SiLiCaP/chipathon-2026/specs/Spec 3 Control Loop and Integration.md

# Spec 3: Control Loop and Integration

Oct 17, 2026 · @A

## Your job

You own control, sequencing and the final wiring. The other four people hand you finished blocks, and you build `ntt_core` around them so all four modes run correctly.

- **In scope:** the op latch and job state machine, all counters, the ROM and γ select, the operand registers, the multiplexers, the bypass delay line, the loop-back path, cancel and reset, and wiring every block together.
- **Out of scope:** the inside of the multiplier, adders, packer and input capture, and the host side.
- **You hold the interface table.** Anyone who wants to change a port asks you first, and you update all five specs.

You are the one person who sees every block, so three things are yours to publish early: the interface table, the per-mode schedule and the output delay table. The section "What you publish to the other four, and when" lists them.

## Who owns which block

You build `ntt_core` and everything inside it except the arithmetic blocks, which you instantiate. The block diagram is on the architecture page listed in the shared rules.

| Block | Module | Owner |
| --- | --- | --- |
| Multiplier | `modq_mul` | Multiplier |
| Add/subtract, one for Pre ± and one for Post ± | `modq_addsub` | Adders |
| Running sums for basemul, two of them | `modq_acc` | Adders |
| Pin capture | `io_in_capture` | I/O |
| Output packer | `io_out_pack` | I/O |
| Tiny Tapeout shell | `tt_um_*` | I/O |
| Host harness, reference model, vectors | not RTL | Pi |
| Everything else in `ntt_core` | `ntt_core` | You |

Inside `ntt_core` you build: the op latch and job FSM, the counters, `zeta_rom` with the ζ / γ select and the scale constant 304, the operand registers (b and a, or g1 f1 g0 f0), the B-input select, the Pre and Post pass-through muxes, the bypass delay line, the loop-back path, the result pairing for scale, and the flush.

`ntt_core` is the boundary with the I/O owner. Its ports are fixed as follows.

| Port | Dir | Width | Meaning |
| --- | --- | --- | --- |
| `clk`, `rst_n` | in | 1 each | Clock and synchronous reset |
| `coeff_q` | in | 12 | Captured coefficient, from `io_in_capture` |
| `valid_q` | in | 1 | Captured valid. The shell masks hash words (coefficient bits 11:8 = 0xF, Spec 5) out of it and out of `sof_q` |
| `sof_q` | in | 1 | High only when valid and sof were both high |
| `op_q` | in | 2 | Captured op. Read only when `sof_q` is high |
| `r0` | out | 12 | First result of a pair |
| `r1` | out | 12 | Second result of a pair |
| `pair_valid` | out | 1 | High for one clock when `r0` and `r1` are valid |
| `flush` | out | 1 | High for one clock when a job is cancelled. Goes to `io_out_pack` |

## Op latch, modes and job lifecycle

A job starts on the clock where `valid_q` and `sof_q` are both high. You latch `op_q` on that clock and run that mode until its last result.

- **Idle.** Wait for `valid_q` and `sof_q`. Coefficients that arrive with `valid_q` but no earlier sof are ignored.
- **Start.** On the sof clock, latch the op, clear every counter, and take this coefficient as the first input of the job.
- **Running.** Take a coefficient on every clock where `valid_q` is high, in the order the mode defines. Clocks with `valid_q` low are skipped and change no counter.
- **End.** After the last pair is emitted the job ends by itself and you return to idle. Extra coefficients after the last expected one are ignored until the next sof.
- **Cancel.** A new sof while running cancels the job. See the cancel section.

You know each job's length from the mode. The host never sends it.

| op | Mode | Inputs | Result pairs out |
| --- | --- | --- | --- |
| 00 | Forward NTT | 1792 | 896 |
| 01 | Inverse NTT | 1792 | 896 |
| 10 | Basemul | 512 | 128 |
| 11 | Scale | 256 | 128 |

## Counters, ROM index and constants

You pick every constant. The host only sends coefficients.

**ROM.** `zeta_rom.v` holds the scaled table ROM′\[k\] = 17^BitRev7(k) × 2197⁻¹ mod 3329 for k = 0..127, where 2197⁻¹ = 944. The multiplier returns 2197 × a × b (three K-RED rounds, see the Multiplier spec), so with a stored ζ′ the product b × ζ′ comes out as b × ζ. It was generated by script and has never been compiled. Compile it, lint it, and compare all 128 entries with the Pi owner's scaled table.

**Forward NTT.** The ROM index starts at 1 and goes up by 1 after every block. A block is `len` butterflies that share one ζ. There are 127 blocks and 896 butterflies.

| len | Blocks | Butterflies per block | ROM indices |
| --- | --- | --- | --- |
| 128 | 1 | 128 | 1 |
| 64 | 2 | 64 | 2 to 3 |
| 32 | 4 | 32 | 4 to 7 |
| 16 | 8 | 16 | 8 to 15 |
| 8 | 16 | 8 | 16 to 31 |
| 4 | 32 | 4 | 32 to 63 |
| 2 | 64 | 2 | 64 to 127 |

**Inverse NTT.** The same table read from the bottom up. `len` goes 2, 4, ..., 128, and the ROM index starts at 127 and goes down by 1 after every block, ending at 1. For len = 2 it covers 127 down to 64, and for len = 128 it is 1.

**Basemul.** A piece counter runs 0..127. With j = i >> 1, the scaled γ′ for piece i is ROM′\[64 + j\] when i is even and 3329 minus that entry when i is odd. One subtractor makes the negative, and no ROM′ entry is 0. The loop-back multiplies m1 by γ′, so m2 = 2197 × m1 × γ′ = m1 × γ.

**Scale.** The constant is 304 = 3303 × 2197⁻² mod 3329 (128 × 3303 = 127 × 3329 + 1), fixed in wiring. The ROM is idle. In the full flow its input already carries one factor of 2197 from basemul, so the multiplier's own 2197 leaves a net factor of 3303.

Checks from the reference model (scaled table): ROM′\[0\] = 944, ROM′\[1\] = 966, ROM′\[2\] = 2021, ROM′\[3\] = 2188, ROM′\[64\] = 2732 and ROM′\[127\] = 2686. γ′ for pieces 0, 1, 2, 3 is 2732, 597, 3106, 223, and for pieces 126, 127 it is 2686, 643. For reference, the unscaled table has ROM\[1\] = 1729, ROM\[64\] = 17, ROM\[127\] = 2154.

## What the pins show because of K-RED

The multiplier returns 2197 × the product. Your scaled constants cancel the factor in both NTT modes, so those are plain. Basemul keeps it, and scale removes it.

| Mode | What the output bytes carry |
| --- | --- |
| Forward NTT | The plain FIPS 203 result |
| Inverse NTT | The plain FIPS 203 result for plain input. For basemul output as input it gives 2197 × the plain result (the transform is linear) |
| Basemul | 2197 × the plain basemul, mod 3329 |
| Scale | c × 3303 × 2197⁻¹ mod 3329 |

So the host flow forward, forward, basemul, inverse, scale gives the correct final polynomial. Scale on its own is not a plain × 3303.

Worked values for your tests:

- Basemul with f0 = 5, f1 = 7, g0 = 11, g1 = 13 and γ = 17 (plain answer c0 = 1602, c1 = 142): the products are m1 = 187, m2 = 3179, m3 = 991, m4 = 2987, m5 = 2719, so the pins give c0 = 841 and c1 = 2377.
- Scale input 2197 gives 3303. Scale input 3259 gives 316. Scale input 1132 gives 26 (inputs that carry 2197, as basemul output does, come out as plain × 3303).
- Forward butterfly with b = 2000, a = 1000, ζ = 1729: t = 2498, a′ = 169, b′ = 1831.

Tell the Pi owner if you change any of this, because the reference model, the vector files and the demo depend on it.

## Per-mode schedules

Every mode repeats on a fixed period: 3 clocks per butterfly in forward and inverse, 5 clocks per basemul piece, and 3 clocks per scale pair. Each mode runs as fast as its real limit allows:

| Mode | Clocks per unit | Limited by |
| --- | --- | --- |
| Forward and inverse NTT | 3 per butterfly | Output pins: 3 bytes per butterfly |
| Basemul | 5 per piece | Multiplier: 5 products per piece, one start per clock |
| Scale | 3 per pair | Output pins: 3 bytes per pair |

The multiplier starts on consecutive clocks in basemul and scale (full rate, Oct 17 change). In the NTT modes it starts once every 3 clocks because the pins can't carry results any faster.

The tables below are the required cadence. Publish them as `schedule.md`. Offsets are clocks from the unit's first input, and idle clocks have `valid` low.

**Forward NTT, one butterfly (period 3)**

| Offset | Host sends | Chip does |
| --- | --- | --- |
| 0 | b | Capture b |
| 1 | a | Start b × ζ right away, because only b is multiplied. Hold a |
| 2 | idle | Multiplier digit clocks |
| t arrives | none | Post ±: a + t and a − t. Pair out: r0 = a', r1 = b' |

**Inverse NTT, one butterfly (period 3)**

| Offset | Host sends | Chip does |
| --- | --- | --- |
| 0 | b | Capture b |
| 1 | a | Capture a |
| 2 | idle | Pre ±: a + b and b − a, into the Pre ± output register (`REG_OUT` = 1) |
| 3 | next b | Start (b − a) × ζ. Delay a + b. `zeta_r` still holds this unit's ζ′ on this clock |
| product arrives | none | Pair out: r0 = a + b (delayed), r1 = (b − a) × ζ |

The inverse needs both inputs before the multiplier can start, and the Pre ± result is registered (see Timing closure), which is why its output delay is larger than forward's.

**Basemul, one piece (period 5)**

The host sends g1, f1, g0, f0 on 4 consecutive clocks, then one idle clock, and the next piece starts at 5. Core offsets count from the clock g1 is on `coeff_q`. With L\_mult = 3:

| Core offset | Host sends | Chip does |
| --- | --- | --- |
| 0 | g1 | g1 → R0. Look up γ′ → `zeta_r` |
| 1 | f1 | f1 → R1 |
| 2 | g0 | g0 → R2. Start m1 = f1 × g1 |
| 3 | f0 | f0 → R3. Start m5 = f1 × g0 |
| 4 | idle | Start m4 = f0 × g1 (last use of g1) |
| 5 | next g1 | Start m2 = m1 × γ′, with m1 taken straight from `p_out` as it arrives. The next piece's g1 → R0 and its γ′ lookup happen on this clock; `zeta_r` still holds this piece's γ′ |
| 6 | next f1 | Start m3 = f0 × g0. m5 back: acc1 ← m5 |
| 7 | | m4 back: acc1 ← acc1 + m4 = c1 |
| 8 | | m2 back: acc0 ← m2 |
| 9 | | m3 back: acc0 ← acc0 + m3 = c0 |
| 10 | | Pair out: r0 = c0, r1 = c1 |

- f1 and g1 come first because f1 × g1 × γ is the only chain of two multiplications. m2 starts exactly L\_mult clocks after m1.
- The multiplier starts on 5 consecutive clocks (2 to 6). The next piece's starts are 7 to 11, so they never collide.
- Every operand register is read for the last time before the next piece overwrites it: g1 at 4 (next write at 5), f1 at 3 (6), g0 at 6 (7), f0 at 6 (8).
- c1 loads m5 and adds m4; c0 loads m2 and adds m3. Both accumulators hold until the pair goes out at 10, before the next piece loads them at 11 and 13.

**Scale, one pair (period 3)**

The host sends c and c′ on consecutive clocks, then one idle clock. Each result is c × 304 (net c × 3303 in the full flow, see the K-RED section).

| Core offset | Host sends | Chip does |
| --- | --- | --- |
| 0 | c | c → R0 |
| 1 | c′ | Start c × 304. c′ → R1 |
| 2 | idle | Start c′ × 304 |
| 4 | | First product back: hold as r0 |
| 5 | | Pair out: r0 = held, r1 = second product |

Streaming job lengths with this cadence: forward and inverse 896 butterflies × 3 = 2688 clocks, basemul 128 × 5 = 640, scale 128 pairs × 3 = 384. These exclude the host's waits between NTT layers.

## Latency and alignment

Results must reach the Post ± stage together, so you delay the shorter lane to match the longer one.

- **Forward.** t = b × ζ arrives L\_mult clocks after the multiplier starts. The bypass value a waits in a delay line of the same length before Post ±.
- **Inverse.** The bypass lane carries a + b. The product (b − a) × ζ arrives L\_mult clocks after the start. Delay a + b to match.
- **Basemul.** m2 needs m1, so the 5-clock schedule above is built for L\_mult = 3 exactly. A multiplier with another latency needs a new schedule (and new host constants), so Spec 2 fixes the latency at 3.
- **Output delay D.** The first byte of a pair leaves D clocks after the pair's first input. The handoff assumed D = 5 forward and 7 inverse. The real value is the sum of the stage latencies below plus your own register stages.

| Stage | Owner | Reports |
| --- | --- | --- |
| Input capture | I/O | 1 clock |
| Multiplier | Multiplier | L\_mult = 3 (pipelined, one result per clock) |
| Add/subtract | Adders | 0 or 1 clock per instance |
| Output packer | I/O | 1 clock |
| Your registers, muxes and delay lines | You | Your own count |

Compute D for each mode and send the numbers to the Pi owner as `host_timing.md`. If D for forward comes out above 5, that is fine. Only a constants file on the host changes. With L\_mult = 3 and the cadence above, D = 6 forward, 8 inverse, 12 basemul and 7 scale (basemul: 1 capture + 10 + 1 packer; scale: 1 + 5 + 1). Forward is one clock over the handoff because the multiplier takes b from a register, one clock after it arrives. Inverse is one clock over the earlier 7 because the Pre ± result is registered.

Also check that `pair_valid` is never closer than 3 clocks apart, and add that as an assertion.

## Timing closure (Oct 17 change)

**Target:** 50 MHz (20 ns) at the slow corner (ss, 100 °C, 1.60 V) after place and route, with no setup or hold violation. Check it in the gds run's post-PnR STA: `local-ci/run gds` shows it on the results page, or read `runs/wokwi/*-openroad-stapostpnr/max_ss_100C_1v60/max.rpt`.

Why: before this change the chip missed the target by 3.6 ns, so it could compute wrong products on a hot or slow die. The worst path ran from the op latch through the `kind` decode and the multiplier's operand mux into the 12 × 12 multiply. The select logic alone took 14.5 ns, mostly fanout buffers driving the select across 24 mux bits; the multiply took about 9.5 ns.

Rules for the multiplier's inputs:

1. **Operand selects come straight from flip-flops.** Decode them one clock early, from the next clock's op and schedule position, into one-hot registers (one bit per source). The operand mux is then one AND-OR level.
2. **Pre ± uses `REG_OUT` = 1.** No adder sits in front of the multiplier. Inverse starts its product at offset 3, as in the table above.
3. **m2's loop-back operand comes from `p_out` directly.** The basemul schedule fixes that m1 is on `p_out` on the m2 start clock, so no comparison on the result tag sits in front of the multiplier.
4. **The ζ/γ lookup is short.** The ROM index logic runs from mode flags decoded into their own registers one clock early, not from the heavily loaded op latch. The γ negation for odd pieces (3329 − x) happens in a separate register one clock after the lookup, off the lookup path; m2 reads that register.

Measured on the full chip (LibreLane, post-PnR, slow corner, worst setup slack at 50 MHz):

| Change | Worst slack | Cell area |
| --- | --- | --- |
| Before (combinational `kind` decode, `PRE_LAT` = 0) | −3.59 ns | 36.4k µm² |
| Split the 12 × 12 multiply into two 12 × 6 halves (rejected) | −3.33 ns | 37.2k µm² |
| Rule 2 only | −2.14 ns | 37.7k µm² |
| Rule 1 only | −0.62 ns | 36.5k µm² |
| Rules 1 and 2 | +0.12 ns | 37.5k µm² |
| Rules 1 to 3 with the full-rate schedule | −0.47 ns (the ζ/γ lookup is now worst) | 37.6k µm² |
| **Rules 1 to 4 with the full-rate schedule (as built)** | **+1.41 ns, 0 violations** | 38.1k µm² |

With all four rules the worst path is the registered operand select through the 12 × 12 multiply. The multiplier block itself doesn't change. Re-check the slack in the gds run after any change to Control.

## Reset, cancel and flush

- **Reset.** `rst_n` low clears the counters, the operand register, the delay lines and the op latch. The chip is then idle and ready for a start of frame.
- **Start of frame.** A pin word with `sof` and `valid` both high starts a job. Latch `op` on that clock only, reset the counters, and drop any job still in progress.
- **Cancel.** A new start of frame always wins. Send `flush` to the output packer in the same clock so stale bytes are dropped.
- **Idle.** With `valid` low and no job running, every output is 0x00 and nothing toggles needlessly.
- **Unused op.** All four op codes are used, so there is no illegal code. Check the table anyway.

## Tests

- **Whole-core, per mode.** Run `ntt_core` with the other four blocks against the Pi owner's reference model: one forward layer, one inverse layer, basemul of two random polynomials, and scale.
- **Full flow.** Forward NTT of f and g, basemul, inverse NTT, scale. The result must equal schoolbook negacyclic multiplication mod 3329.
- **Output delay.** Measure D for each mode from the waveform. It must match `host_timing.md`.
- **Rates.** Check clocks per butterfly (3), per basemul piece (5) and per scale pair (3).
- **Reset and cancel.** Reset mid-job. Start a new frame mid-job. Both must leave no stale bytes.

## Deliverables and done when

**Hand over:**

- `ntt_core.v` with the ROM, counters, muxes, delay lines and control
- The interface table (every port, width and latency of the four blocks you connect)
- `schedule.md` (input offsets per mode) and `host_timing.md` (D and rates per mode)
- A whole-core testbench

**Done when:**

- All four modes match the reference model.
- The full polynomial multiply flow matches schoolbook.
- The assembled design passes the Tiny Tapeout flow.
- Post-PnR STA meets 50 MHz at the slow corner (see Timing closure).

**Do not:** change another owner's ports without agreeing it with them first.

## Risks to watch

- **Multiplier latency changes.** The basemul schedule depends on L\_mult = 3 (m2 starts on the clock m1 arrives). Any change to the multiplier's latency means a new schedule and new host constants.
- **Output delay differs from the handoff.** D of 5 and 7 are assumptions. Send the real numbers to the Pi owner early.
- **Area.** The ROM is 128 × 12 bits. If it does not fit, use the γ symmetry to store only 64 entries for basemul and derive the rest.
- **Layer-by-layer round trips.** The host re-sends data for every NTT layer because the chip stores nothing. Check the host counts against the timing table.

## Shared rules for all five specs

- **One chip, one clock.** Everything runs on `clk`. Reset is `rst_n`, active low. Synchronous logic only, no latches, no generated clocks.
- **Numbers.** Every coefficient is 12 bits, unsigned, always in 0..3328 on every port.
- **Ports are frozen.** You hold the interface table. Other owners tell you before changing a port, and you tell them.
- **Latency is reported.** Collect every block's latency from its README and publish `host_timing.md`.
- **Reference.** The Pi owner's Python model is the source of truth.
- **Sharing.** These docs are private. Share them with your teammates.
