SiLiCaP/chipathon-2026/schematics/adder.png

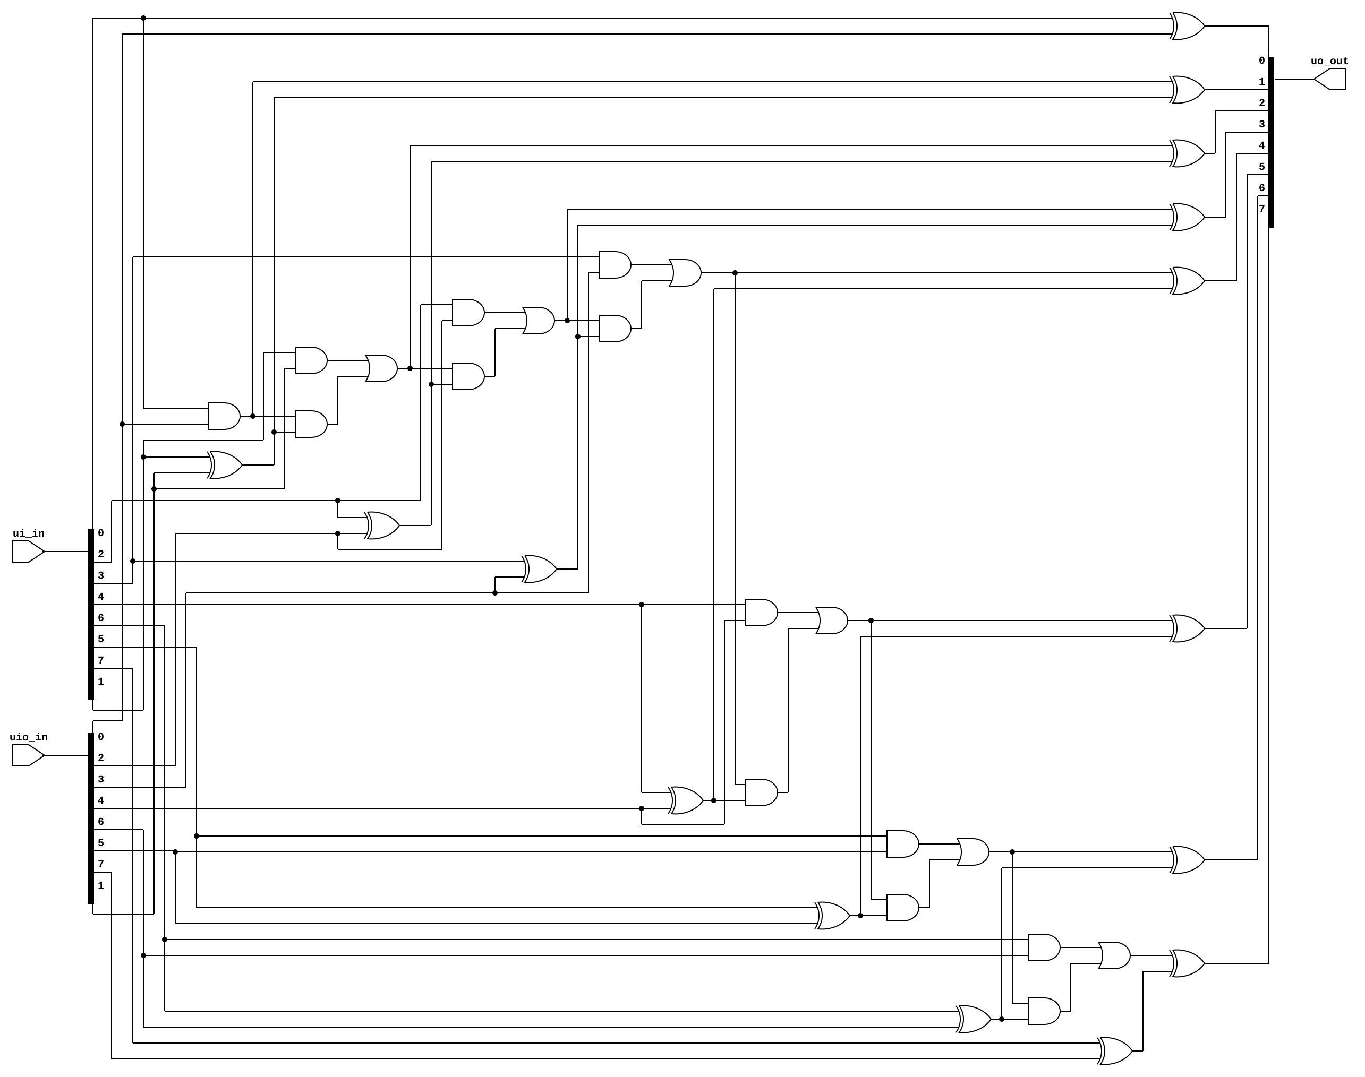
schematics/adder.png
