SiLiCaP/chipathon-2026/schematics/byte_serializer.png

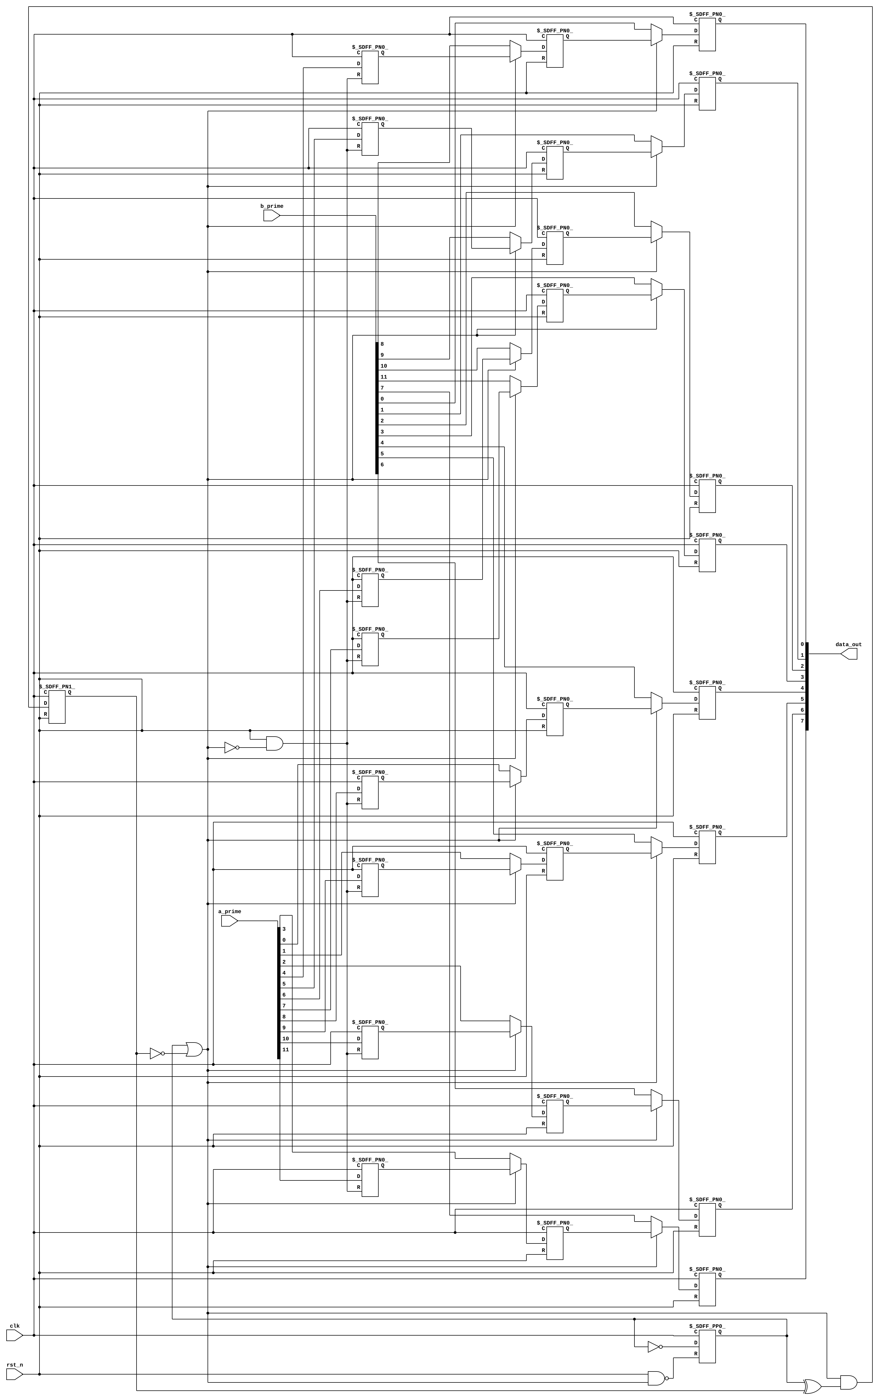
schematics/byte_serializer.png
