SiLiCaP/chipathon-2026/schematics/data_in.png

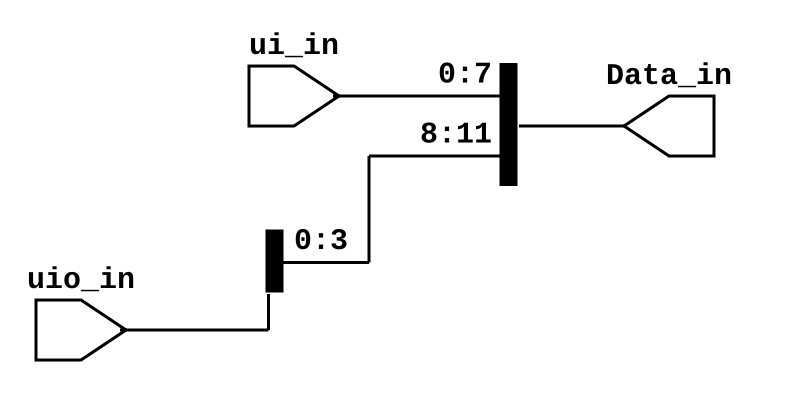
schematics/data_in.png
