SiLiCaP/chipathon-2026/schematics/full.png

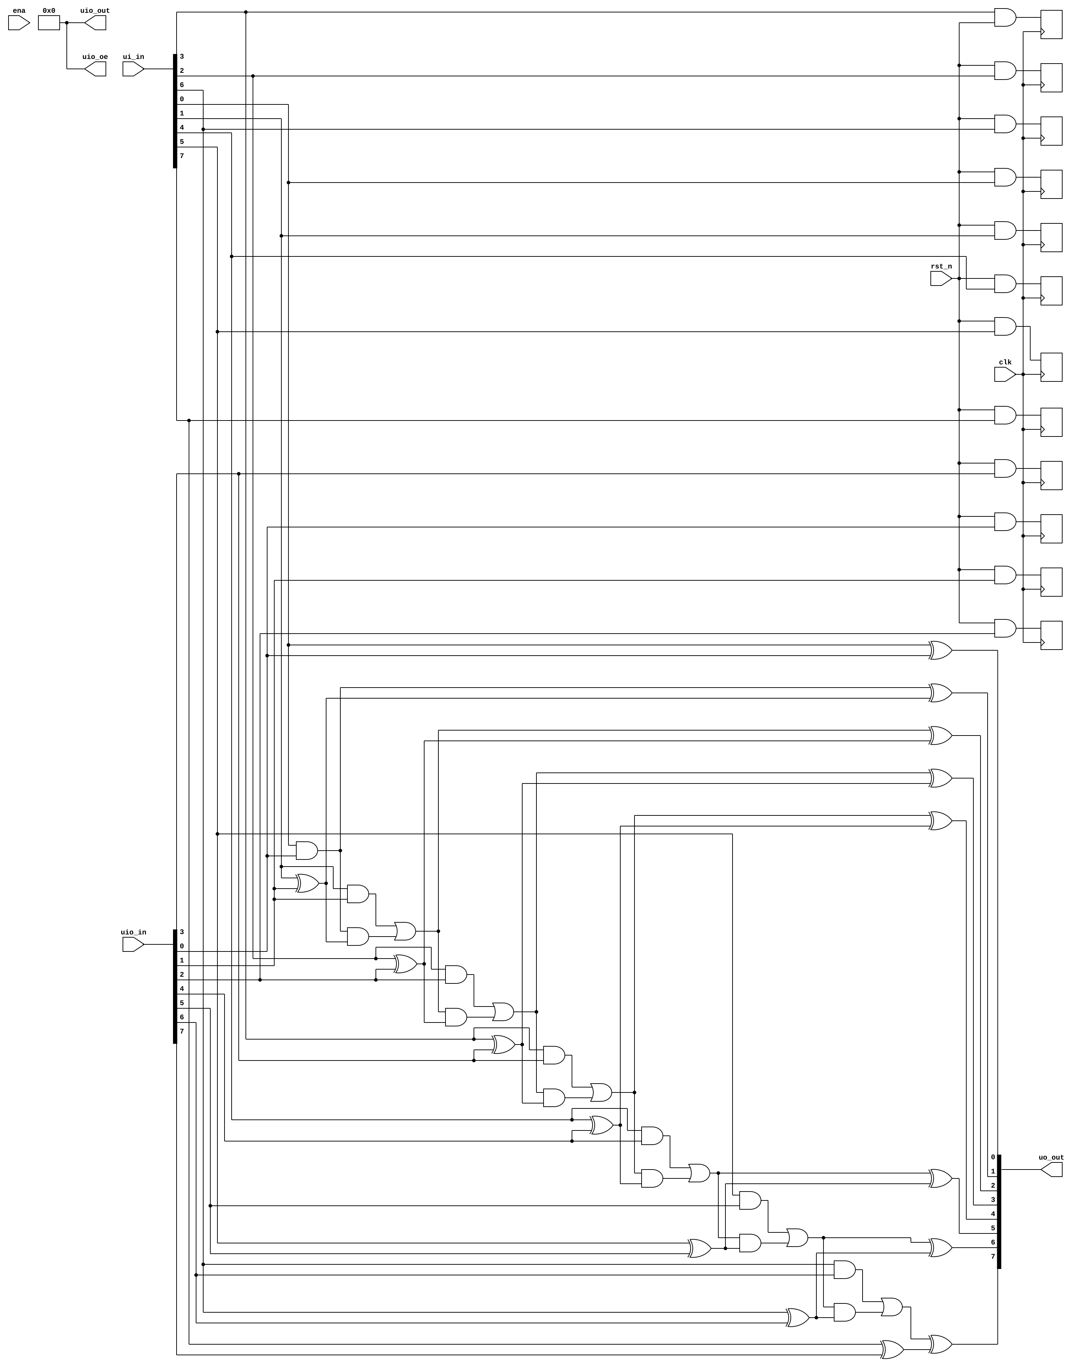
schematics/full.png
