SiLiCaP/chipathon-2026/schematics/reg12.png

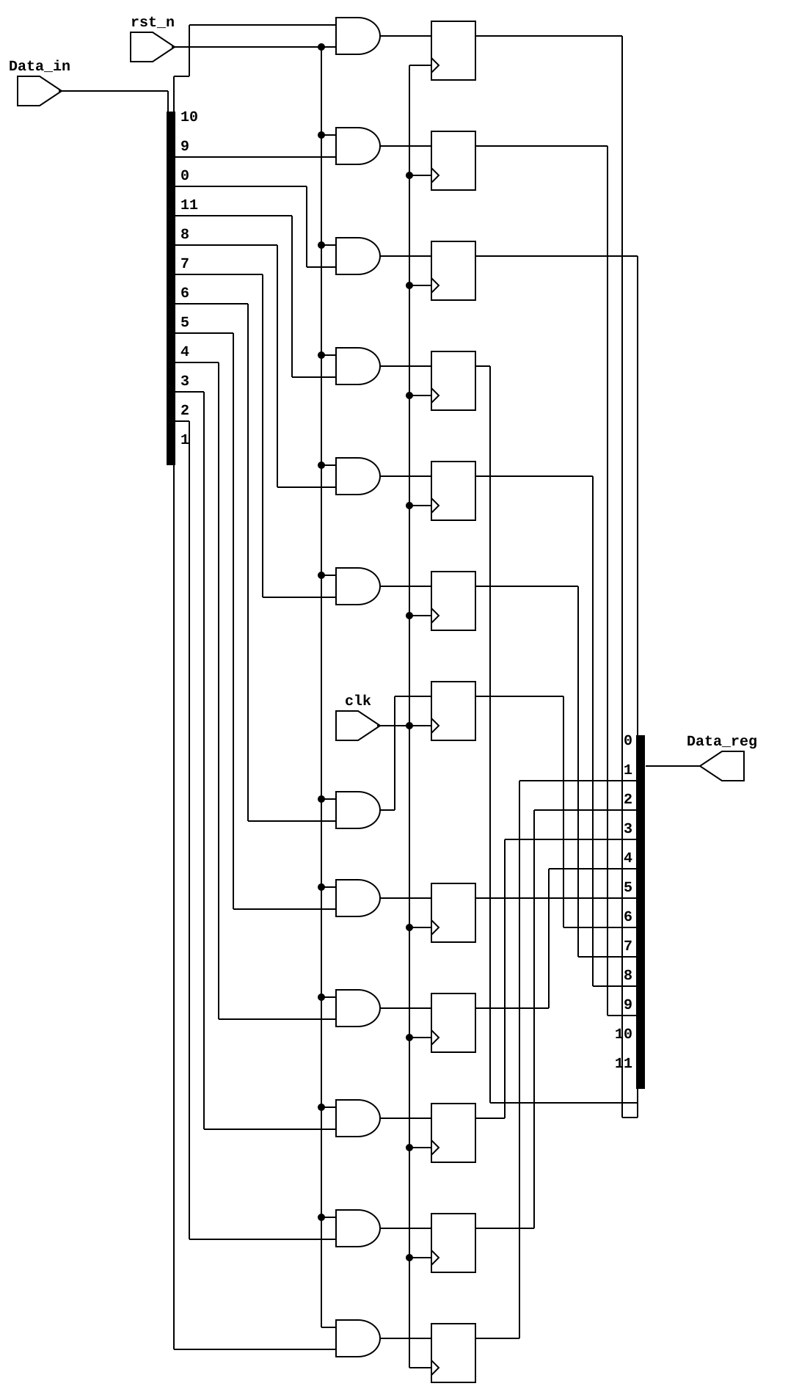
schematics/reg12.png
