SiLiCaP/chipathon-2026/schematics/reg_bit.png

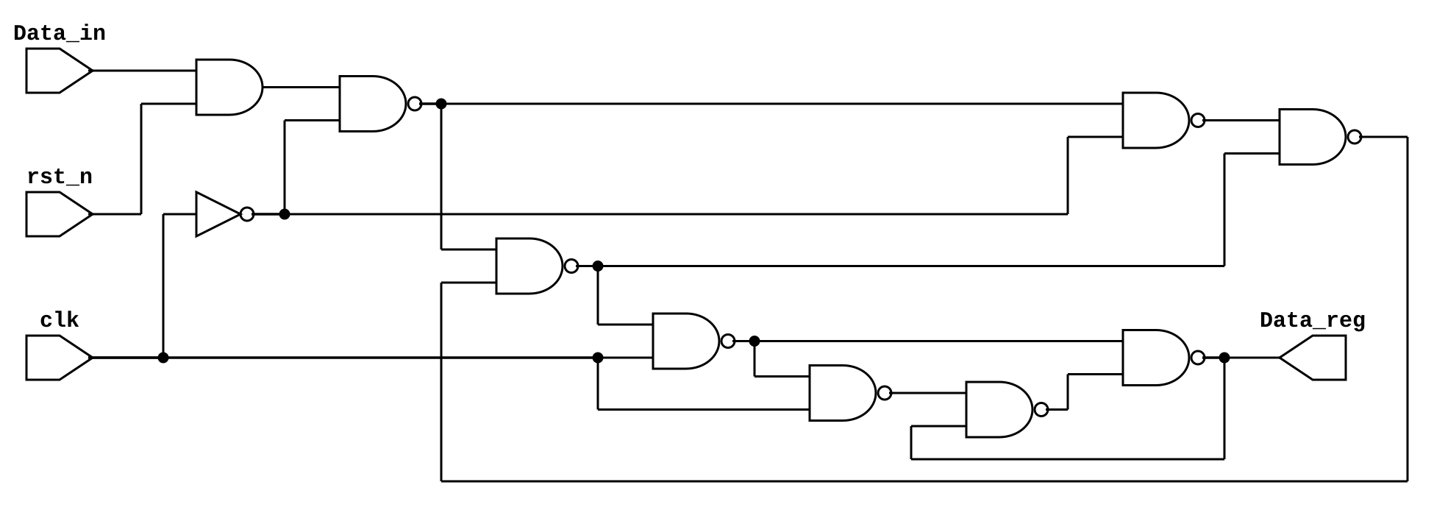
schematics/reg_bit.png
