SiLiCaP/chipathon-2026/(commit log)

2026-10-17 fix(io): follow Spec 5 for the pins, input capture and output packer
    The shell used a BUSY output on uio[4] and loaded b, a, b, a by counting
    words. Spec 5 has no back-pressure: every uio pin is an input, uio[4] is
    valid, uio[5] sof and uio[7:6] op, and results leave at a fixed delay.
    The host harness (Spec 1) and the control schedule (Spec 3) rely on that.
    - tt_um_NTT_Core.v (was project.v): the Spec 5 wiring
    io_in_capture -> ntt_core -> io_out_pack, uio_oe = uio_out = 0.
    - io_in_capture.v: new, one register stage from the pins.
    - io_out_pack.v (was byte_serializer.v): same shift register, with the
    Spec 5 ports (pair_valid, r0, r1, flush, uo_byte), r0 first as in
    ByteEncode12, and fl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
    [io_in_capture.v, tt_um_NTT_Core.v]
2026-10-17 feat(control): ntt_core per Spec 3
    ntt_core with all four modes (forward NTT, inverse NTT, basemul, scale),
    built from:
    - ntt_ctrl: op latch, job lifecycle, input and pair counters, cancel
    - ntt_sched: multiplier start schedule per mode, basemul piece timer
    (passes m1, m3, m2, m4, m5) and a tag line that routes each result
    - ntt_twiddle: zeta' index per butterfly (forward and inverse) and
    gamma' for basemul, from zeta_rom
    - zeta_rom: the scaled table zeta * 2197^-1 (replaces twiddle_rom, which
    held the unscaled table), generated by scripts/gen_tables.py
    - ntt_delay: bypass and tag delay lines
    modq_addsub and modq_acc are placeholders written to Spec 4.
    Output delays (multiplier latenc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
2026-10-17 docs: add architecture options for 4 and 8 tiles
    Exploration for the tile negotiation (ML-KEM-512, TT demo board): what 2x2
    and 4x2 buy, a full-rate multiplier schedule, a block engine, measured
    Keccak cores against published compact designs, a 50 vs 66 MHz clock
    sweep, and the SRAM question. Numbers are reproducible in
    github.com/SiLiCaP/tt-viktor-chiptor.
2026-10-17 docs: SHA-3 report - why hashing decides ML-KEM-512 speed, options and the pin-leak catch
2026-10-17 rp2350: RP2350 harness and demo per Spec 1 (PIO + DMA firmware, PC build, software chip)
    Firmware for the TT demo board v3 drives tt_um_NTT_Core in lockstep with a two-instruction
    PIO program and DMA, with exact clock counts (10,983 for the demo). It runs the Spec 1
    known answers, the polynomial-multiply demo, fuzzing against the chip-level model and the
    k = 2 matrix-vector stretch goal, and also speaks the Tang Nano TTE1 protocol over USB.
    The same C core builds on a PC. It passes against the software chip and on a Tang Nano
    running both the tt_um_NTT_Core RTL and its hardened sky130 gate netlist. Timing constants
    are generated from test/timing.py; CI builds the UF2 and runs the harness te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
2026-10-17 rp2350: Pico 2 W + Tang Nano test target and an operation timing log
    - TT_TARGET=pico2w_tang builds the firmware for a Raspberry Pi Pico 2 W wired pin for pin
    to a Tang Nano 20K running the chip's gate netlist (wiring: tt-viktor-chiptor
    docs/PICO_TANG_RIG.md). The 16 input pins wrap the PIO window at GPIO 26 (the Pico 2 W
    has 26 free GPIOs); dbv3 stays the default. Each firmware checks the RP2350 package at
    boot and leaves the pins alone on the wrong board.
    - core/oplog.c times every batch (build, stream, rig conversion, unpack) and call in CPU
    cycles (DWT counter); commands log, log csv, predict <hz>; bench prints where the time
    goes. tt-viktor-chiptor tools/rp_log.py fits the s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
    [main.c, tt_rp.c, tt_rp.h]
2026-10-17 spec: hash words (coefficient bits 11:8 = 0xF) in Specs 1, 3 and 5
    Spec 5: the pin map and the shell describe the Keccak core and the masking.
    Spec 3: valid_q / sof_q arrive with hash words masked out.
    Spec 1: the host's hash commands, busy times and squeeze delay.
2026-10-18 feat: hash command SKIP (4): the host passes over all-zero lanes in one word
    keccak_ring takes a 3-bit command; the shell drives {sof, op} (sof is free in
    hash words). SKIP moves the byte pointer to the next lane and leaves it
    untouched; 5..7 are no-ops. The pin-level hash test runs every case with and
    without SKIP (the GL subset has both), and the interleaved test uses it.
    docs/info.md and Specs 1 and 5 list the new command.
    [keccak_ring.v, tt_um_NTT_Core.v]
2026-10-18 docs: NTT cache study for the 4x2 build
    Compares the block engine (four RTL variants, measured on sha3-4x2-cache), a
    half-polynomial buffer and reusing the Keccak state: area (plain and TT-flow
    synthesis), clocks per job, host packing, the 4x2 fit from hardens with the
    default and the relaxed hold constraints, and the ML-KEM-512 exchange time from
    an extended copy of the overlap model. research/ntt_cache has the models, the
    area-estimate RTL and the synthesis scripts.
2026-10-18 feat: hash-only chip, NTT removed; burst squeeze and SamplePolyCBD on chip
    The NTT core and its tests are gone; the chip is the Keccak-f[1600] sponge (keccak_ring, K = 8,
    368 clocks per permutation) behind a new host adapter, src/hash_io.v:
    - the sha3-4x2 pin protocol unchanged (commands 0-4), so existing host code still runs
    - BURST (5): one word streams 8n state bytes, one per clock
    - BURST_CBD (6): the same bytes as FIPS 203 SamplePolyCBD coefficients (eta 2 and 3), so a PRF
    call returns ML-KEM's secret / noise coefficients directly
    - K = 16 support (bytes paired in the adapter, 172 clocks per permutation); keccak_ring's
    counter width generalized for K = 16
    config.json carries the tea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
    [hash_io.v, hash_jobs.py, keccak_ring.v, tb.v, test_hash_only.py, tt_um_NTT_Core.v]
2026-10-18 docs: tile sizes, routes and the hash-only chip (branch sha3-only)
    Every branch evaluated; routes hardened at 2x2 / 3x2 (K = 2 fits 2x2 clean, K = 8 needs 3x2);
    speed of each route including the RP2350's feed; the ML-KEM-512 instruction profile; the NTT-free
    chip on branch sha3-only (burst squeeze + SamplePolyCBD, K = 8 and K = 16 tests pass, 42/42 jobs
    bit-exact on the Pico 2 W + Tang Nano rig up to 13.5 MHz, wiring verified); local harden times.
2026-10-18 docs: hash-only chip passes over Tang USB too; the UART issue was the wedged debugger
2026-10-18 info.yaml: 3x2 (hash-only K = 8 + CBD signs off clean there: 55.5 %, +8.17 ns slow corner, 0 DRC / LVS / antenna; 2x2 is too congested)
2026-10-18 rp2350: firmware from main (Pico 2 W + Tang Nano target, timing log) + software SHA-3 reference
    - rp2350/ brought over from main (39d53bf): the rig target TT_TARGET=pico2w_tang and the operation
    timing log, so this branch's chip runs on the same harness
    - core/sha3_sw.c: FIPS 202 sponge (portable C Keccak-f[1600]) and SamplePolyCBD packed like the chip's
    BURST_CBD output: the RP2350-alone reference for a measured RP2350-vs-chip hash benchmark.
    Compiled in, not yet called: the next step is a TTE1 HASH command (PC sends a message, the RP2350 runs
    it on the chip via PIO and in software, returns both cycle counts) - see tt-viktor-chiptor docs/HANDOFF.md
    Builds for pico2w_tang (pico-sdk 2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
2026-10-30 host CI: FPGA emulator in the repo (fpga/, tools/rig_pincheck.py, docs/PICO_TANG_RIG.md); host-ci.yaml (4x2 variant, 2x3 research die)
    fpga/ is imported from tt-viktor-chiptor @af81927 and maintained here from now on.
2026-10-30 CI emulator check, contract 2: the ML-KEM-512 hash sequence on the hash-only chip
    The RP2350 firmware was still the NTT firmware from the old main. Replace it with a driver for the hash chip:
    - core/hash_chip.c: sponge jobs (SHA3-256/512, SHAKE128/256, PRF + BURST_CBD eta 2/3) as the exact pin words of
    test/hash_jobs.py, over the unchanged PIO/DMA transport (core/tt_io.h); checks uo_out is quiet when no byte is due.
    - core/hash_swchip.c: pin-level software model of hash_io + keccak_ring (K = 8) for the PC build, flags protocol
    violations; hash_app.c: selftest (known answers, rate-edge sweeps, SKIP, burst, CBD), fuzz, cal; sha3_sw.c is the
    reference.
    - ci command / app_ci consumes a ge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
2026-10-30 docs: host CI research die example numbers (measured 2x3 trial), ctl research
2026-10-30 info.yaml: fun fact, the 2x3 research die
2026-10-31 fpga: model the sky130 clock-gate cell (dlclkp) for the gate-level emulator
    The hash chip's ring Keccak gates its clocks with sky130_fd_sc_hd__dlclkp_1 (47 instances). The liberty
    file describes it with a statetable, which yosys's read_liberty skips, so the GL bitstream build failed
    with 'Module sky130_fd_sc_hd__dlclkp_1 referenced ... not found'. Modelled as a negative-edge enable
    flop ANDed with CLK, equivalent to the latch for a GATE that settles before CLK falls. Checked on the
    host: the Tang Nano 20K bitstream for main's netlist builds (0 errors).
    [sky130_phys_cells.v]
2026-10-31 host/tt_emu.py: the emulator's PC-side driver, imported from tt-viktor-chiptor (tools/rig_pincheck.py needs it)
2026-10-31 docs: onchip_offload redone with viktor's route model (pin + RP2350 feed vs compute), new ranking
2026-10-31 docs: host CI findings; TT tile heights are 1, 2 or 4 rows (not 'at most 2')
    docs/host_ci_findings.md, measured on the d0b0 host, Oct 30-31: 3x2 stays the best shape; moving the I/O
    pins makes timing worse; 4x2 fails sign-off on hold with the current SDC; K=16 does not route at 4x2; TT
    heights are 1/2/4 rows (3x4 is the smallest tall size, there is no 3x3, 2x3, 2x4 or 2x6). Corrects the
    size lists in info.yaml, host-ci.yaml and docs/host-ci.md.
2026-11-01 rp2350: reset the chip before every hardware check (the FPGA is loaded after the Pico boots, so the chip answered all zeros)
    [main.c]
2026-11-01 fpga: GL emulation converts the netlist's clock gates to clock enables
    The 47 sky130 dlclkp cells were modelled with a negedge flop + AND, which the fabric turns into
    a glitchy, skewed gated clock: the GL bitstream gave run-to-run wrong digests. gl_icg_to_ce.py
    (run by the Makefile when GL=1, opt out with GL_CE=0) removes every ICG and gives each flop that
    sat on a gated clock the root clock plus a recirculating mux (D' = GATE ? D : Q). The rest of the
    netlist is untouched. Hardware (Tang Nano 20K + Pico): selftest PASS, all PASS.
    [gl_icg_to_ce.py]
